cdgarciag/Sensor-Color/FPGA blackice 40hx4k.jpg

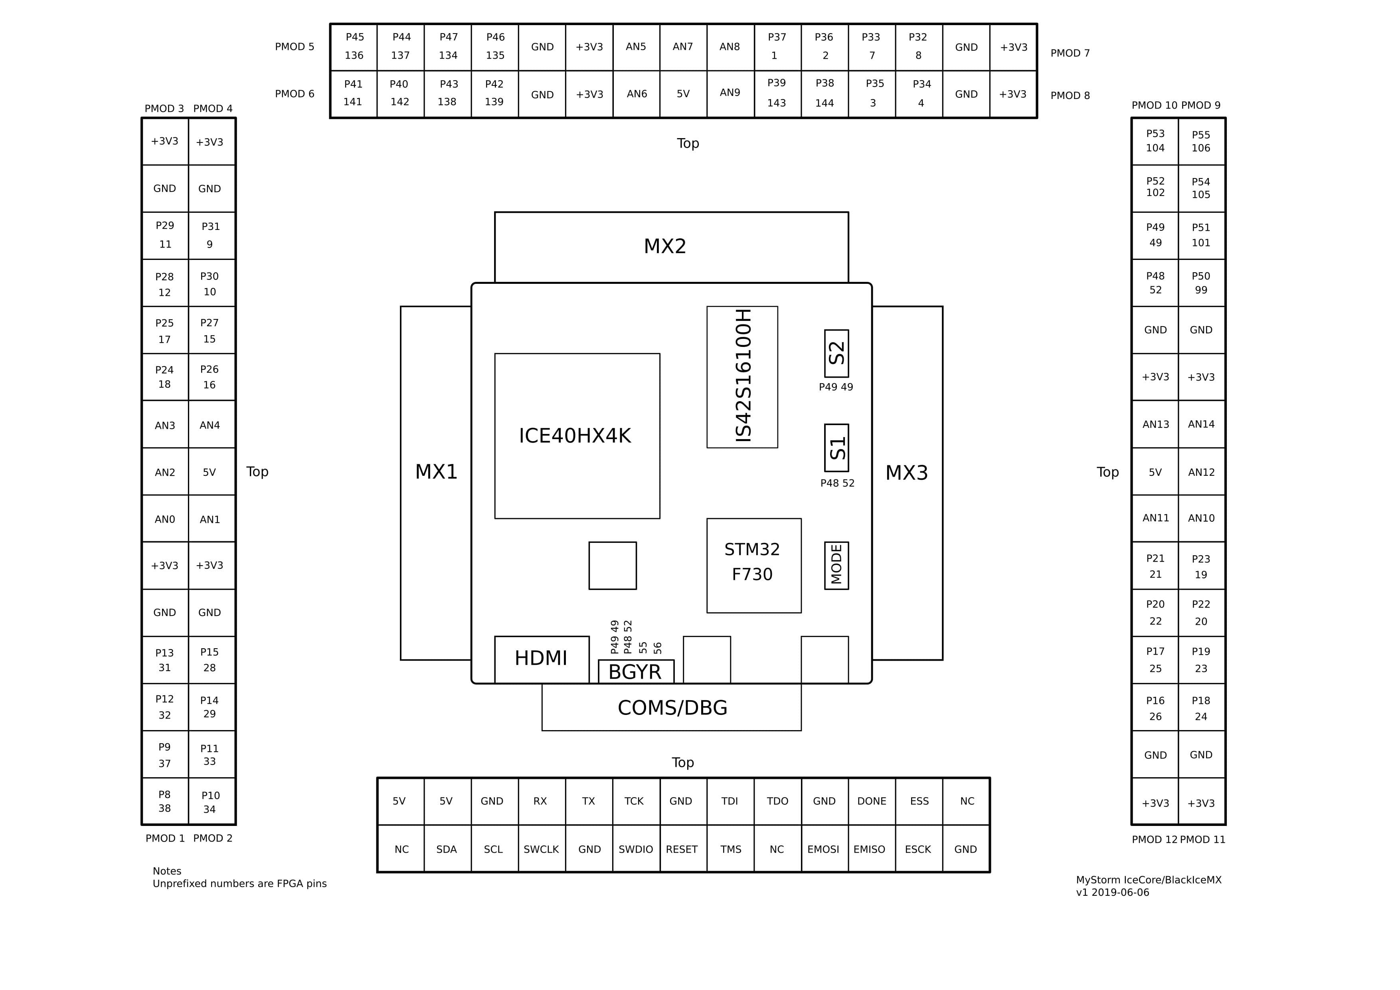
FPGA blackice 40hx4k.jpg
