cdgarciag/Sensor-Color/(commit log)

2024-09-23 agregar diagrama de flujo
2024-09-23 imagen diagrama de flujo
2024-09-23 diagrama de flujo segundo intento
2024-09-23 subir video sensor TCS3200 primeras pruebas
2024-09-23 correccion saltos de linea
2024-09-23 Sensor color
2024-09-23 datasheet de fpga y sensor TCS3200
2024-09-27 Add files via upload
    Diagrama de bloques
